JulianKarrer/kishte/kishte_schematic/schematic.pdf

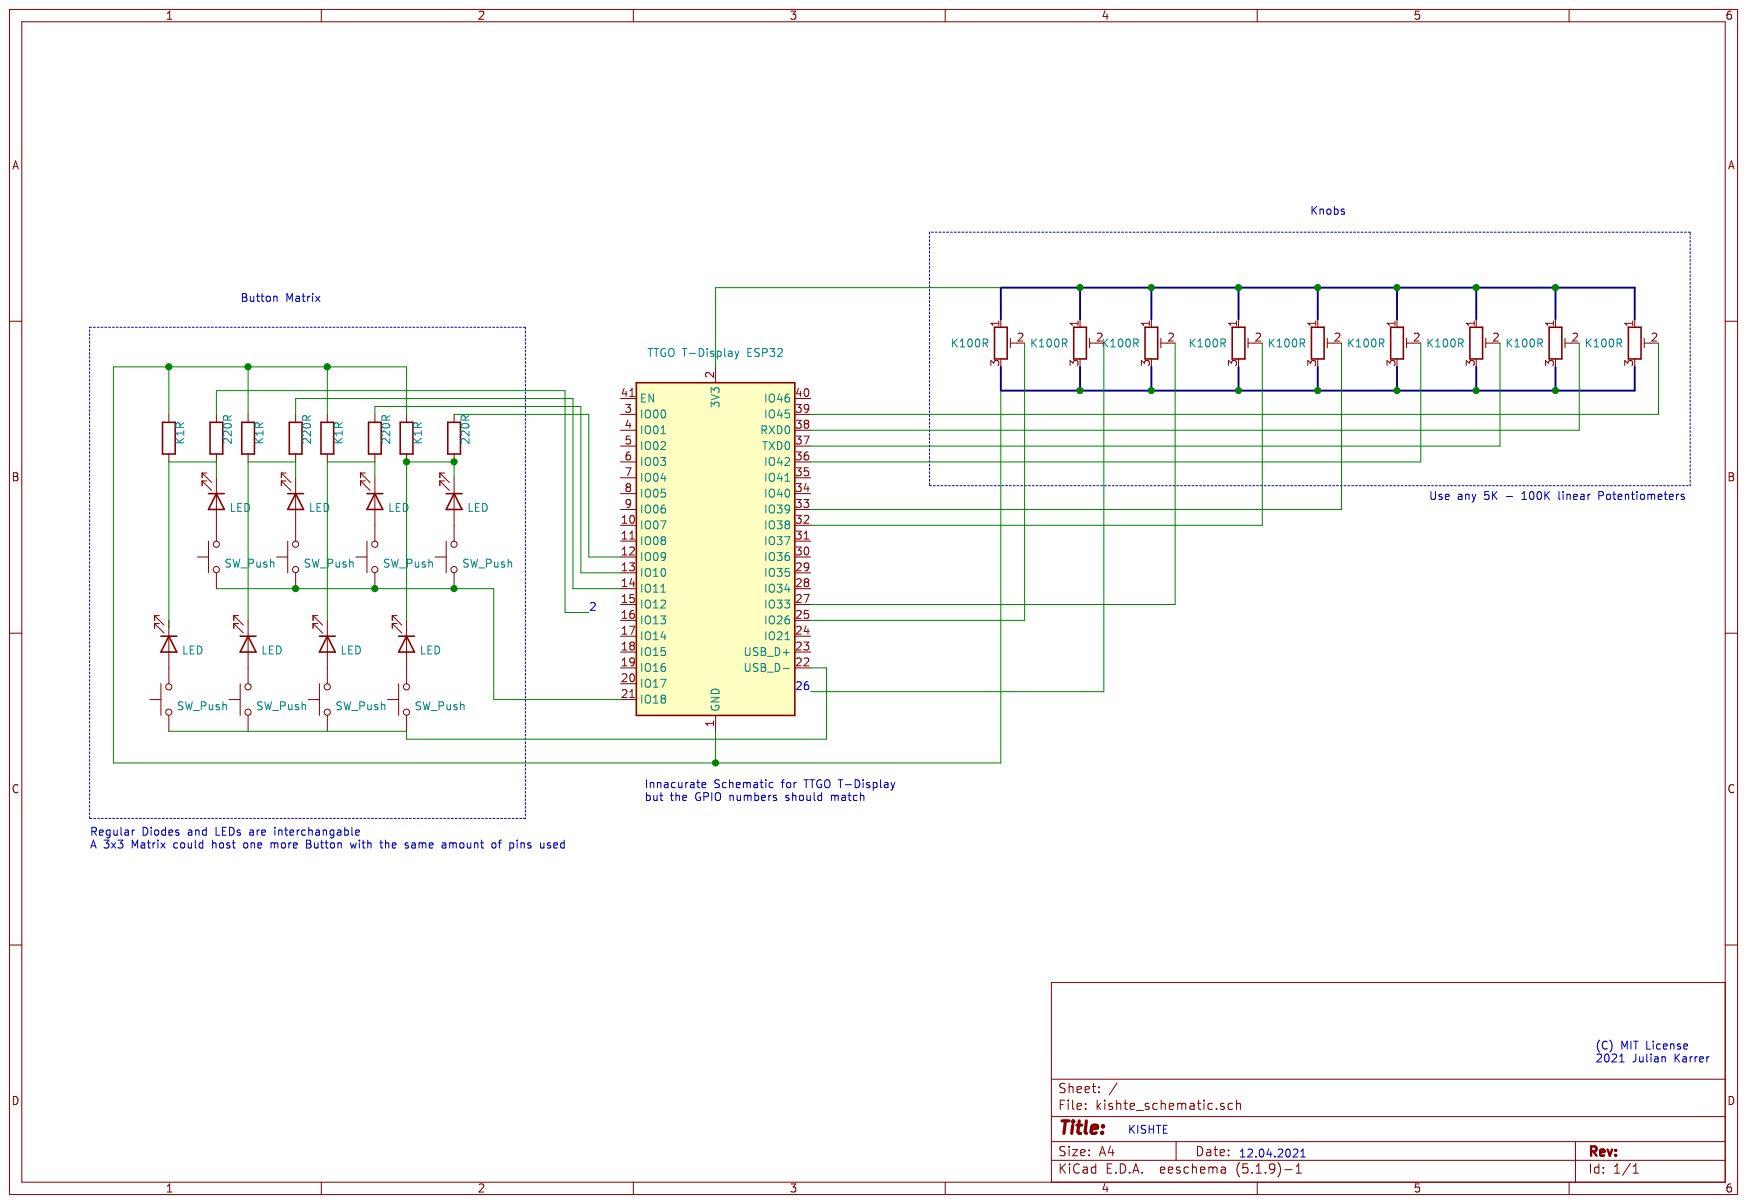
[picture p1: page 1]
