JulianKarrer/kishte/(commit log)

2021-04-12 Add Electron Client Add schmematic Capture desktop audio, pipe to SerialBT, draw on device
    [kishte_schematic.kicad_pcb, kishte_schematic.sch]
2022-03-08 Add README Switch to yarn for electron-build
